championwescott/curling-scoreboard/curling-scoreboard.kicad_sch

## KiCad design curling-scoreboard.kicad_sch (2025-09-02)

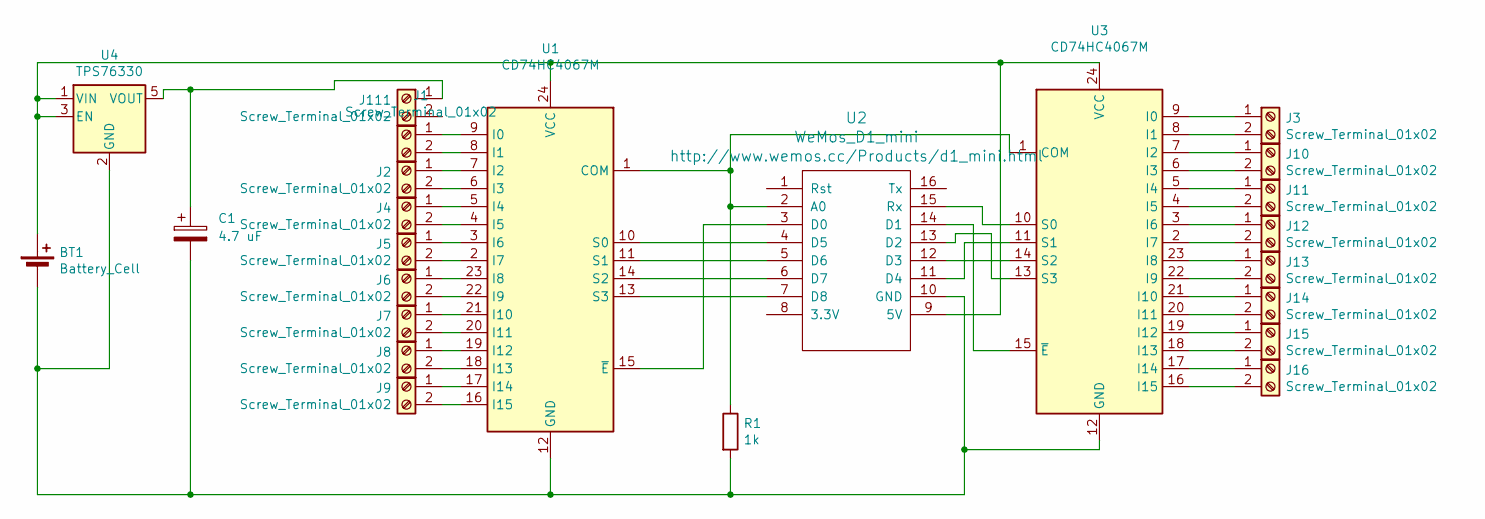
[picture p1: schematic curling-scoreboard.kicad_sch]

Parts:
BT1: Battery_Cell; BarrelJack_Horizontal
C1: 4.7 uF
J1, J2, J3, J4, J5, J6, J7, J8, J9, J10, J11, J12, J13, J14, J15, J16, J111: Screw_Terminal_01x02; TerminalBlock_Altech_AK300-2_P5.00mm
R1: 1k; R_Axial_DIN0411_L9.9mm_D3.6mm_P5.08mm_Vertical
U1, U3: CD74HC4067M; 74hc4607_new
U2: WeMos_D1_mini; wemos-d1-mini-with-pin-header-and-connector
U4: TPS76330; SOT-23-5

Connections:
unnamed: BT1.1 (+), U1.24 (VCC), U2.9 (5V), U3.24 (VCC), U4.1 (VIN), U4.3 (EN)
unnamed: BT1.2 (-), C1.2, R1.2, U1.12 (GND), U2.10 (GND), U3.12 (GND), U4.2 (GND)
unnamed: C1.1, J111.1, U4.5 (VOUT)
unnamed: J1.1, U1.9 (I0)
unnamed: J1.2, U1.8 (I1)
unnamed: J2.1, U1.7 (I2)
unnamed: J2.2, U1.6 (I3)
unnamed: J3.1, U3.9 (I0)
unnamed: J3.2, U3.8 (I1)
unnamed: J4.1, U1.5 (I4)
unnamed: J4.2, U1.4 (I5)
unnamed: J5.1, U1.3 (I6)
unnamed: J5.2, U1.2 (I7)
unnamed: J6.1, U1.23 (I8)
unnamed: J6.2, U1.22 (I9)
unnamed: J7.1, U1.21 (I10)
unnamed: J7.2, U1.20 (I11)
unnamed: J8.1, U1.19 (I12)
unnamed: J8.2, U1.18 (I13)
unnamed: J9.1, U1.17 (I14)
unnamed: J9.2, U1.16 (I15)
unnamed: J10.1, U3.7 (I2)
unnamed: J10.2, U3.6 (I3)
unnamed: J11.1, U3.5 (I4)
unnamed: J11.2, U3.4 (I5)
unnamed: J12.1, U3.3 (I6)
unnamed: J12.2, U3.2 (I7)
unnamed: J13.1, U3.23 (I8)
unnamed: J13.2, U3.22 (I9)
unnamed: J14.1, U3.21 (I10)
unnamed: J14.2, U3.20 (I11)
unnamed: J15.1, U3.19 (I12)
unnamed: J15.2, U3.18 (I13)
unnamed: J16.1, U3.17 (I14)
unnamed: J16.2, U3.16 (I15)
unnamed: R1.1, U1.1 (COM), U2.2 (A0), U3.1 (COM)
unnamed: U1.10 (S0), U2.4 (D5)
unnamed: U1.11 (S1), U2.5 (D6)
unnamed: U1.13 (S3), U2.7 (D8)
unnamed: U1.14 (S2), U2.6 (D7)
unnamed: U1.15 (~E), U2.3 (D0)
unnamed: U2.11 (D4), U3.11 (S1)
unnamed: U2.12 (D3), U3.14 (S2)
unnamed: U2.13 (D2), U3.13 (S3)
unnamed: U2.14 (D1), U3.15 (~E)
unnamed: U2.15 (Rx), U3.10 (S0)
